DavidMolTor/TENG/Readme.md

# TENG

Research project on TENG energy harvesting.

## Introduction

TODO

## Features

TODO
