DavidMolTor/TENG/hardware/output/Rotor_Bottom.png

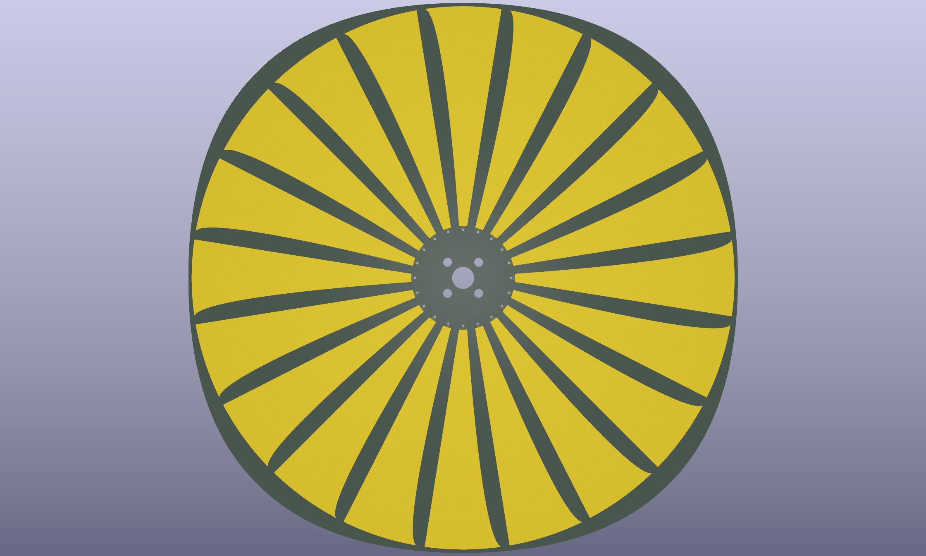
hardware/output/Rotor_Bottom.png
