DavidMolTor/TENG/hardware/output/Rotor_Front.png

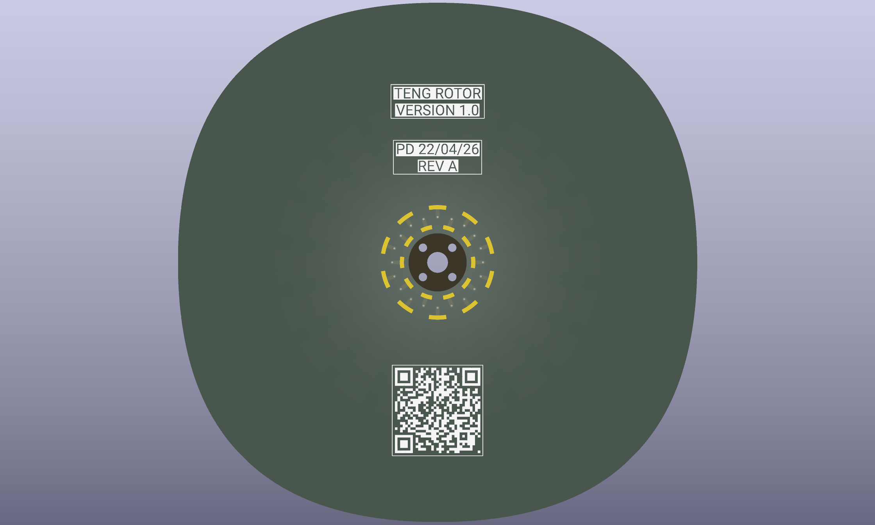
hardware/output/Rotor_Front.png
