DavidMolTor/TENG/hardware/output/Stator_Bottom.png

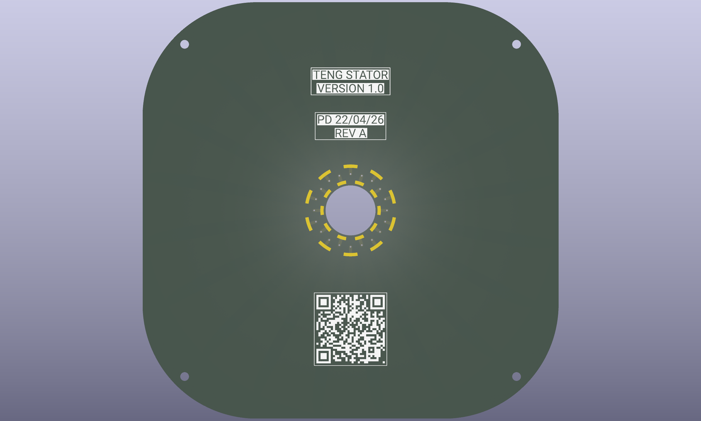
hardware/output/Stator_Bottom.png
