DavidMolTor/TENG/hardware/output/Stator_Front.png

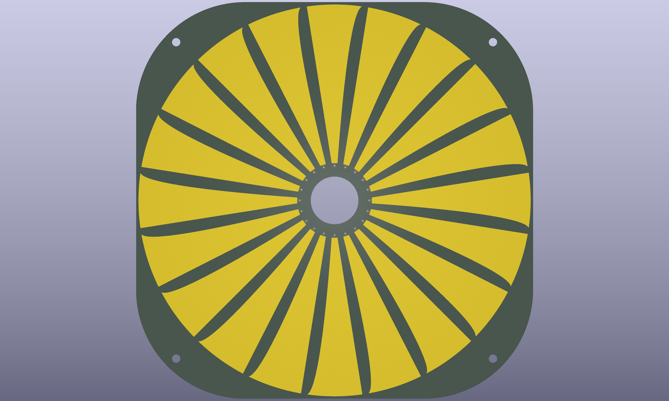
hardware/output/Stator_Front.png
