DavidMolTor/TENG/hardware/output/RotorV2.step

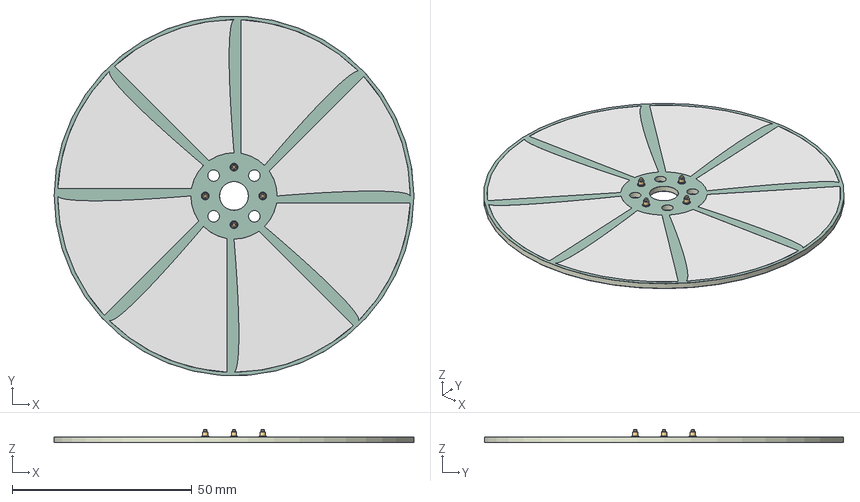
[picture p14: CAD file, 2026-10-27]
hardware/output/RotorV2.step
100.0 x 99.8 x 3.65 mm
Pogo x 4
Rotor_copper
Rotor_pad
Rotor_soldermask x 2
Rotor_PCB
