DavidMolTor/TENG/hardware/output/StatorV2.step

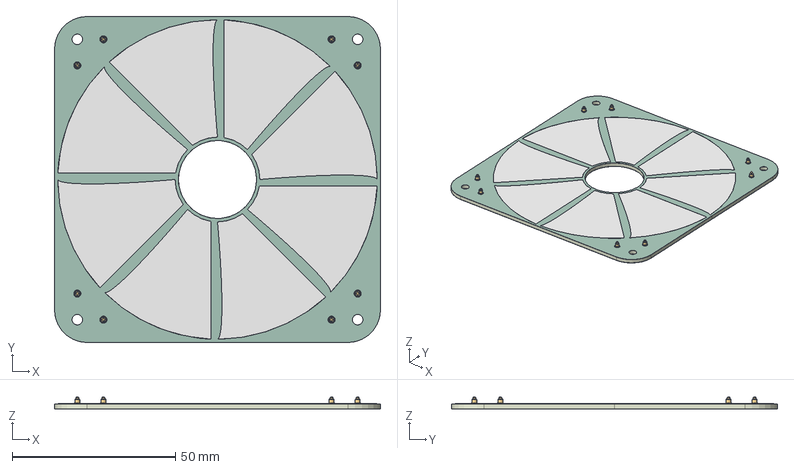
[picture p15: CAD file, 2026-10-27]
hardware/output/StatorV2.step
100.0 x 100.0 x 3.65 mm
Pogo x 8
Stator_copper
Stator_pad
Stator_soldermask x 2
Stator_PCB
