DavidMolTor/TENG/hardware/output/Base.step

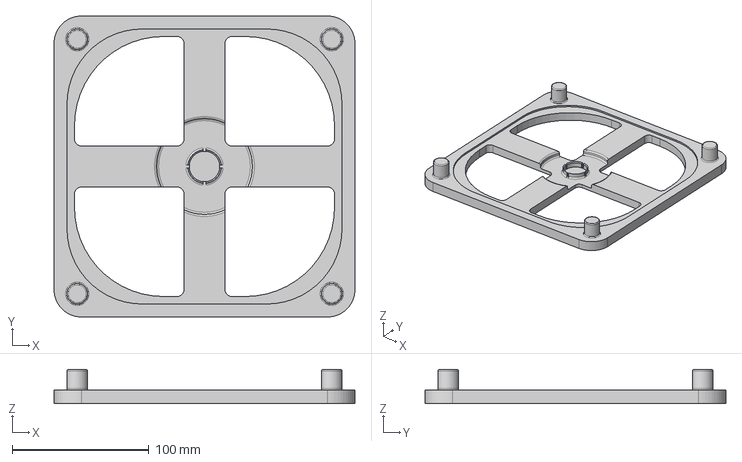
[picture p16: CAD file, 2026-06-24]
hardware/output/Base.step
220.0 x 220.0 x 25.0 mm
