DavidMolTor/TENG/hardware/output/Hub.step

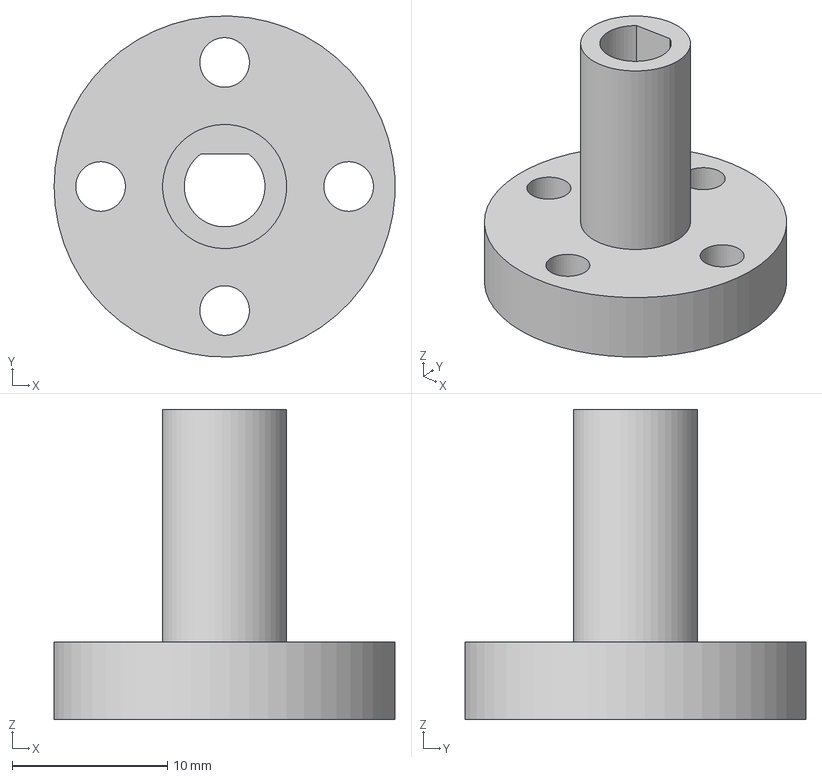
[picture p17: CAD file, 2026-06-24]
hardware/output/Hub.step
22.0 x 22.0 x 20.0 mm
