DavidMolTor/TENG/hardware/output/Top.step

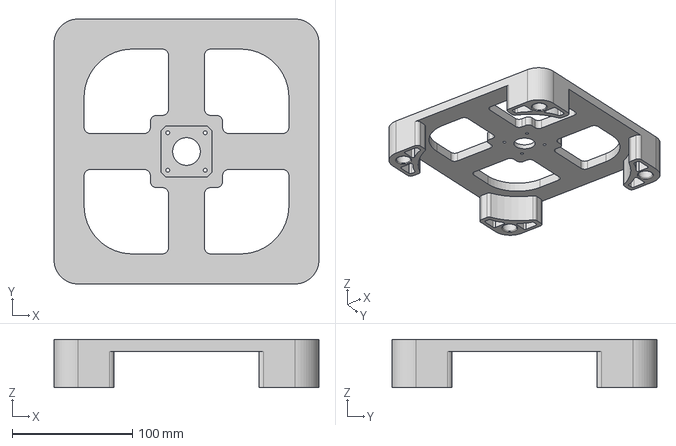
[picture p18: CAD file, 2026-04-27]
hardware/output/Top.step
220.0 x 220.0 x 40.0 mm
