DavidMolTor/TENG/hardware/output/Gasket.step

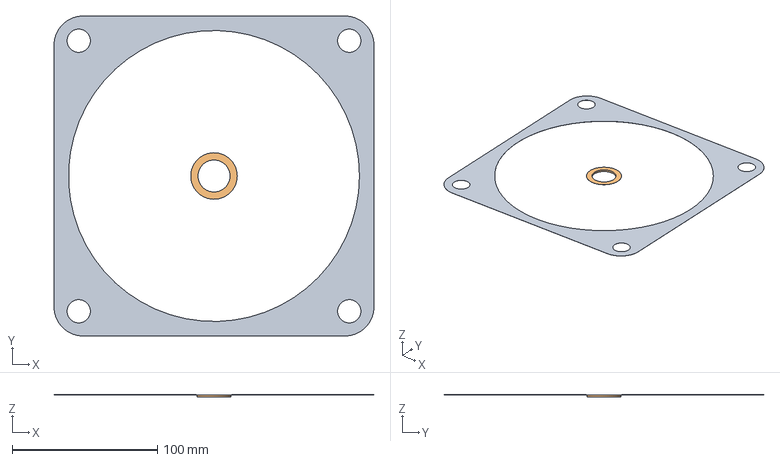
[picture p19: CAD file, 2026-04-27]
hardware/output/Gasket.step
220.0 x 220.0 x 1.70 mm
