DavidMolTor/TENG/hardware/output/Rotor.step

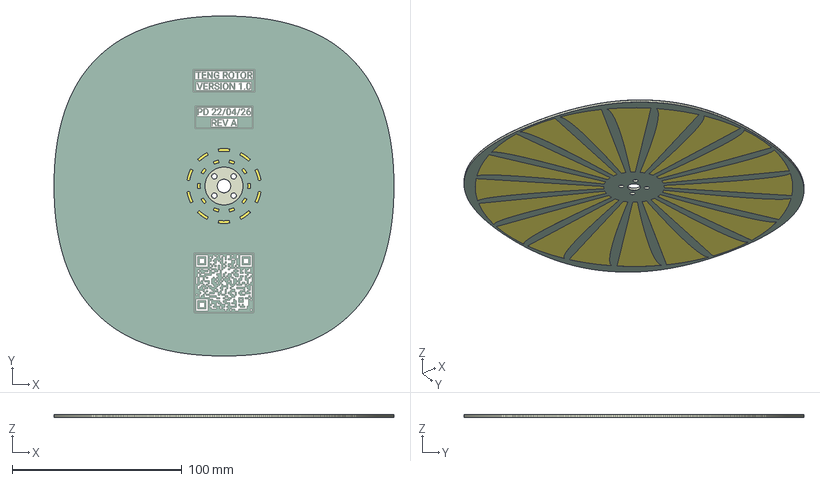
[picture p20: CAD file, 2026-06-24, an earlier design]
hardware/output/Rotor.step
200.0 x 200.0 x 1.64 mm
Rotor_copper
Rotor_via
Rotor_silkscreen
Rotor_soldermask
Rotor_soldermask_1
Rotor_PCB
