DavidMolTor/TENG/(list of files, cad)

Other CAD files:
hardware/output/Stator.step
