DavidMolTor/TENG/simulation/FSS_TENG_SW.asc

B1: bv; V = sigma * d * (1 - V(xt)) / eps0
B2: bv; V=0.5 * (1 + sin(w*time))
C1: cap; Q = Cmin + (Cmax - Cmin)*V(xt)
C2: cap; {Cload}
D1: diode; 1N4148
D2: diode; 1N4148
D3: diode; 1N4148
D4: diode; 1N4148
D5: diode; 1N4148
L1: ind2; 1m; Rser=1m
L2: ind2; 1m; Rser=1m
R1: res; {Rload}
R2: res; 10
S1: sw; SWTENG
Named nets: 0, xt, Vout, Vteng
.tran 0 20 0
* Constant values and derivatives *
.param sigma=100e-6 ; Triboelectric charge density
.param eps0=8.854e-12 ; Absolute permittivity
.param A=pi*R*R/N ; Area per segment
.param Cmax=eps0*A*Ve/d ; Overlap capacitance
.param Cmin=0.05*Cmax ; Minimum capacitance
.param w=N*2*pi*rpm/60 ; Angular velocity
* Configurable parameters *
.param N=10 ; Number of copper contacts
.param rpm=100 ; Rotational speed [rpm]
.param R=0.1 ; TENG radius [m]
.param d=1e-4 ; Air gap [m]
.param Rload=10Meg ; Load resistance[ohm]
.param Cload=2µ ; Load capacitor[F]
.param Ve=100 ; Excitation factor
.step param ix 1 5 1
K1 Lp Ls 1
.model SWTENG SW(Ron=1p Roff=1000Meg Vt=1000 Vh=900)
