DavidMolTor/TENG/simulation/TENG_GDT.asc

B2: bv; V=26.5e-006*V(xt)/8.85e-12
C1: cap; Q=(0.011*8.85e-12/(8.5e-5+V(xt)))*x
C2: cap; 10µ
C3: cap; 10n
D1: diode; 1N4148
D2: diode; 1N4148
D3: diode; 1N4148
D4: diode; 1N4148
R1: res; 1Meg
U1: GDT; 2087; dcVmax=100 Vmax1=200 Vmax2=190 Vglow=45 Varc=15
V1: voltage; SINE(0.42e-3 0.42e-3 3 0 0 -90)
Named nets: 0, xt
.tran 0 20 0 10u
