DavidMolTor/TENG/simulation/TENG_GDT_FULL.asc

B2: bv; V=26.5e-006*V(xt)/8.85e-12
C1: cap; Q=(0.011*8.85e-12/(8.5e-5+V(xt)))*x
C2: cap; 10µ
C3: cap; 4.7n
D1: diode; 1N4148
D2: diode; 1N4148
D3: diode; 1N4148
D4: diode; 1N4148
D5: diode; 1N4148
Lp: ind2; 5m; Rser=1m
Ls: ind2; 5m; Rser=1m
R1: res; 1Meg
U1: GDT; 2087; dcVmax=800 Vmax1=1400 Vmax2=1300 Vglow=45 Varc=13
V1: voltage; SINE(0.42e-3 0.42e-3 3 0 0 -90)
Named nets: 0, xt
.tran 0 5 3
K1 Lp Ls 1
