DavidMolTor/TENG/simulation/TENG_SW.asc

B2: bv; V=26.5e-006*V(xt)/8.85e-12
C1: cap; Q=(0.011*8.85e-12/(8.5e-5+V(xt)))*x
C2: cap; 10µ
D1: diode; 1N4148
D2: diode; 1N4148
D3: diode; 1N4148
D4: diode; 1N4148
D5: diode; 1N4148
Lp: ind2; 1m; Rser=1m
Ls: ind2; 1m; Rser=1m
R1: res; 1Meg
R2: res; 10
S1: sw; SWTENG
V1: voltage; SINE(0.42e-3 0.42e-3 3 0 0 -90)
Named nets: 0, xt, Vteng, Vout, Vsw
.tran 0 10 0
.model SWTENG SW(Ron=1p Roff=1000K Vt=1000 Vh=900)
K1 Lp Ls 1
