DavidMolTor/TENG/hardware/stator/Stator.kicad_pcb

## KiCad design hardware/stator/Stator.kicad_pcb (2026-10-27)

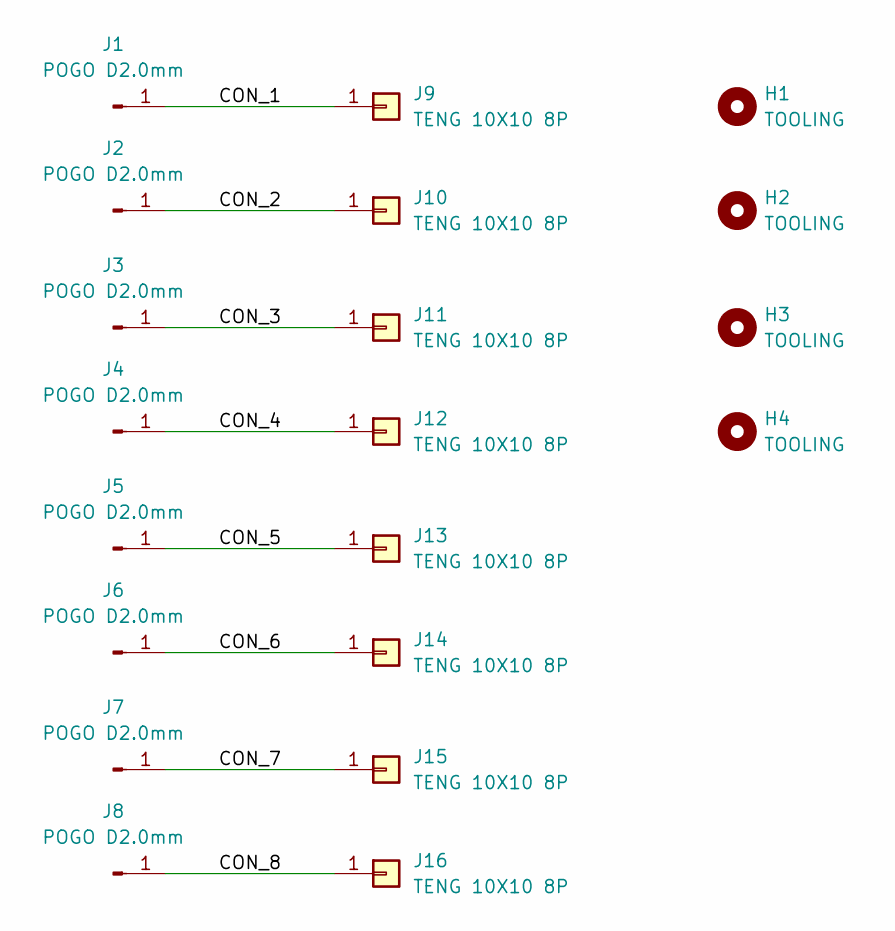
[picture p21: schematic Stator.kicad_sch, FSS TENG STATOR]

Parts:
H1, H2, H3, H4: TOOLING; ToolingHole_1.152mm
J1, J2, J3, J4, J5, J6, J7, J8: POGO D2.0mm; PogoPin_D2.0mm_JOIN; Manufacturer Part YZ203115028R-03; JLC Part C5157421
J9, J10, J11, J12, J13, J14, J15, J16: TENG 10X10 8P; CONTACT_CIRCLE_10X10_8P_HUB

Connections:
/CON_1: J1.1 (Pin_1_1), J9.1 (Pin_1_1)
/CON_2: J2.1 (Pin_1_1), J10.1 (Pin_1_1)
/CON_3: J3.1 (Pin_1_1), J11.1 (Pin_1_1)
/CON_4: J4.1 (Pin_1_1), J12.1 (Pin_1_1)
/CON_5: J5.1 (Pin_1_1), J13.1 (Pin_1_1)
/CON_6: J6.1 (Pin_1_1), J14.1 (Pin_1_1)
/CON_7: J7.1 (Pin_1_1), J15.1 (Pin_1_1)
/CON_8: J8.1 (Pin_1_1), J16.1 (Pin_1_1)

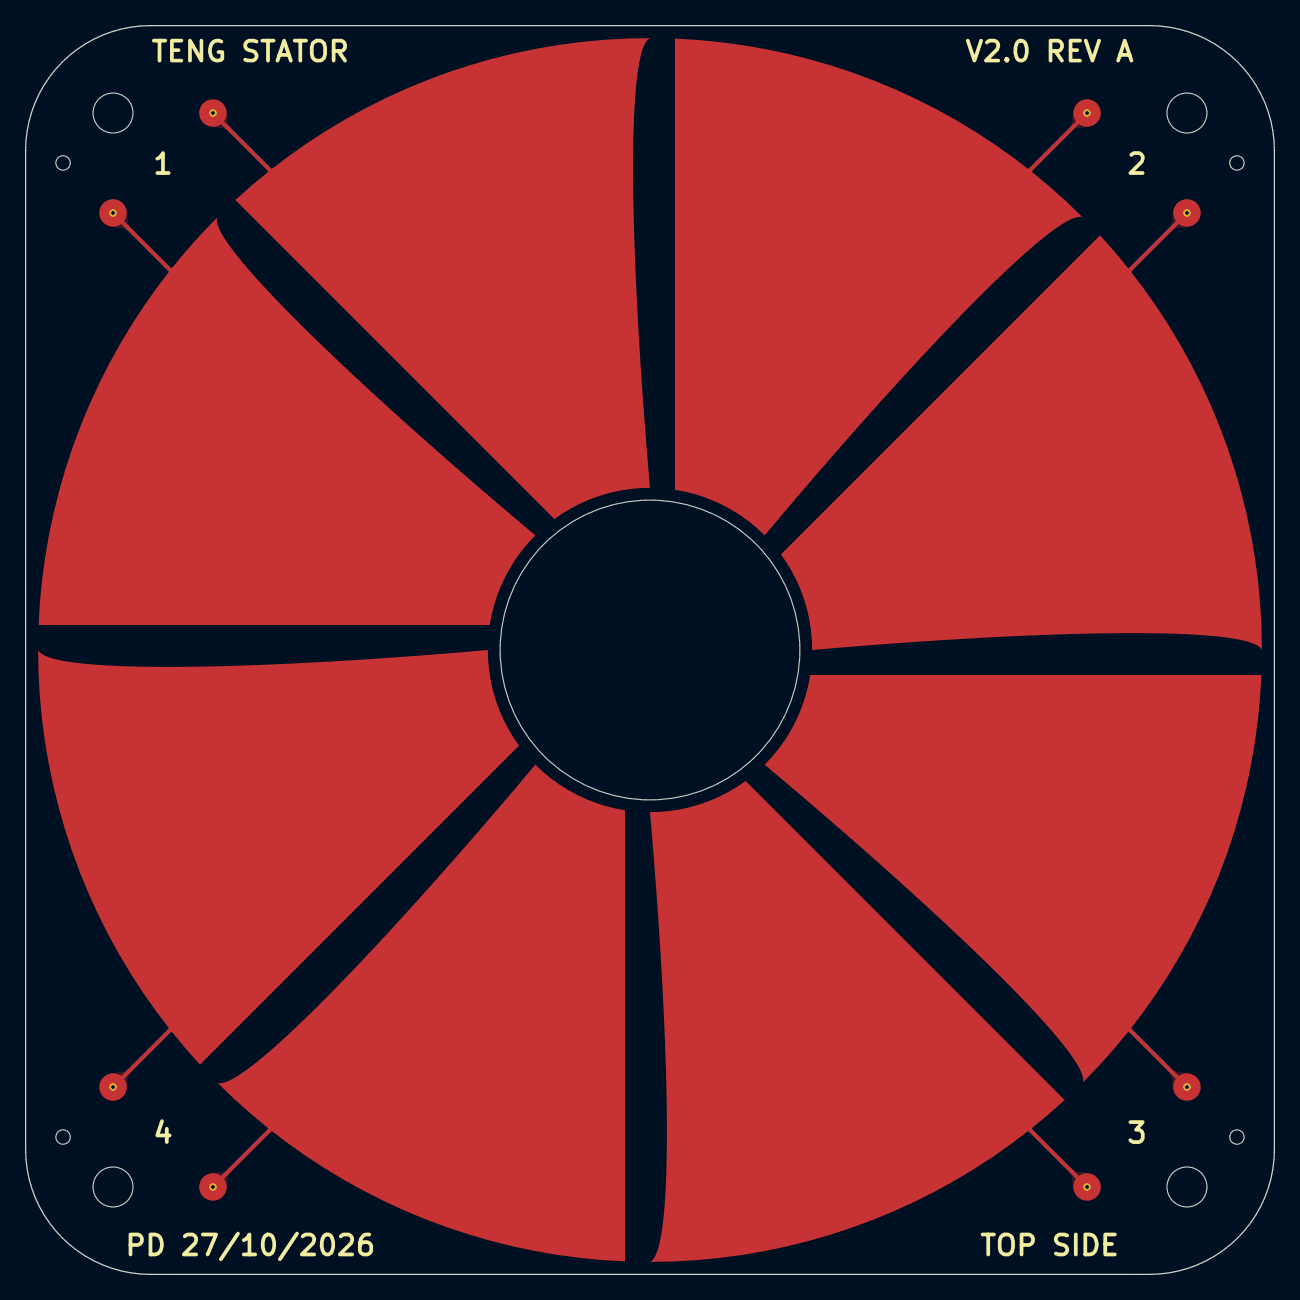
[picture p22: board Stator.kicad_pcb from above]

Board: 2 copper layers, 100.0 x 100.0 mm, 20 parts (0 on the bottom side), 8 nets.
