DavidMolTor/TENG/hardware/rotor/Rotor.kicad_pcb

## KiCad design hardware/rotor/Rotor.kicad_pcb (2026-10-27)

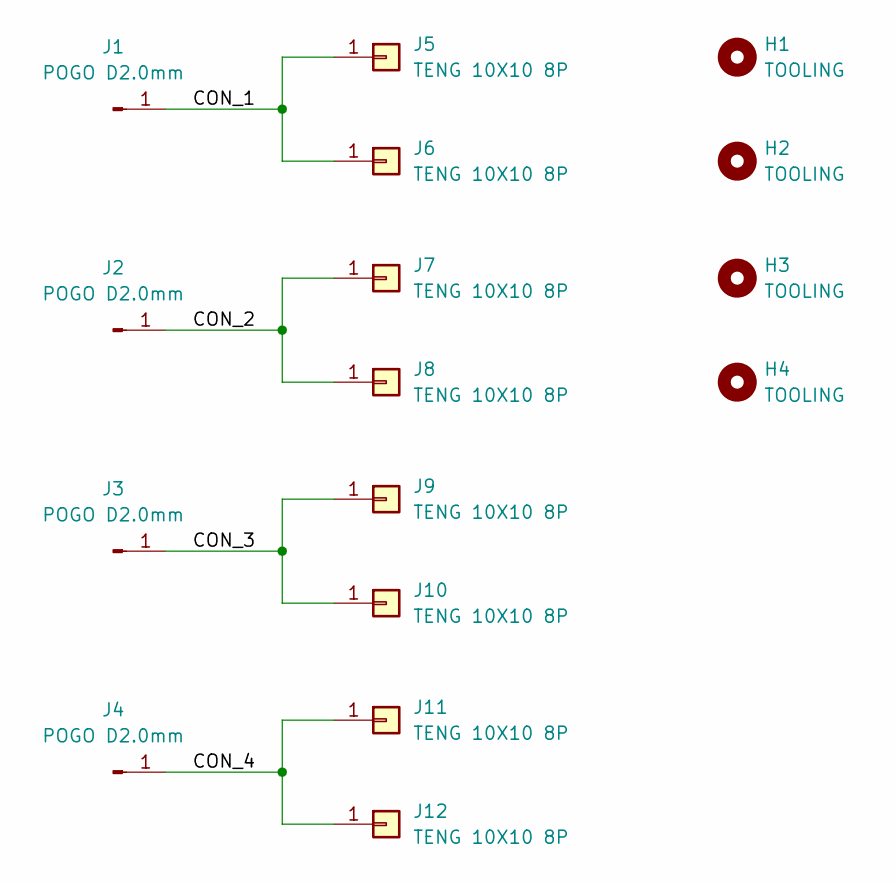
[picture p23: schematic Rotor.kicad_sch, FSS TENG ROTOR]

Parts:
H1, H2, H3, H4: TOOLING; ToolingHole_1.152mm
J1, J2, J3, J4: POGO D2.0mm; PogoPin_D2.0mm_JOIN; Manufacturer Part YZ203115028R-03; JLC Part C5157421
J5, J6, J7, J8, J9, J10, J11, J12: TENG 10X10 8P; CONTACT_CIRCLE_10X10_8P

Connections:
/CON_1: J1.1 (Pin_1_1), J5.1 (Pin_1_1), J6.1 (Pin_1_1)
/CON_2: J2.1 (Pin_1_1), J7.1 (Pin_1_1), J8.1 (Pin_1_1)
/CON_3: J3.1 (Pin_1_1), J9.1 (Pin_1_1), J10.1 (Pin_1_1)
/CON_4: J4.1 (Pin_1_1), J11.1 (Pin_1_1), J12.1 (Pin_1_1)

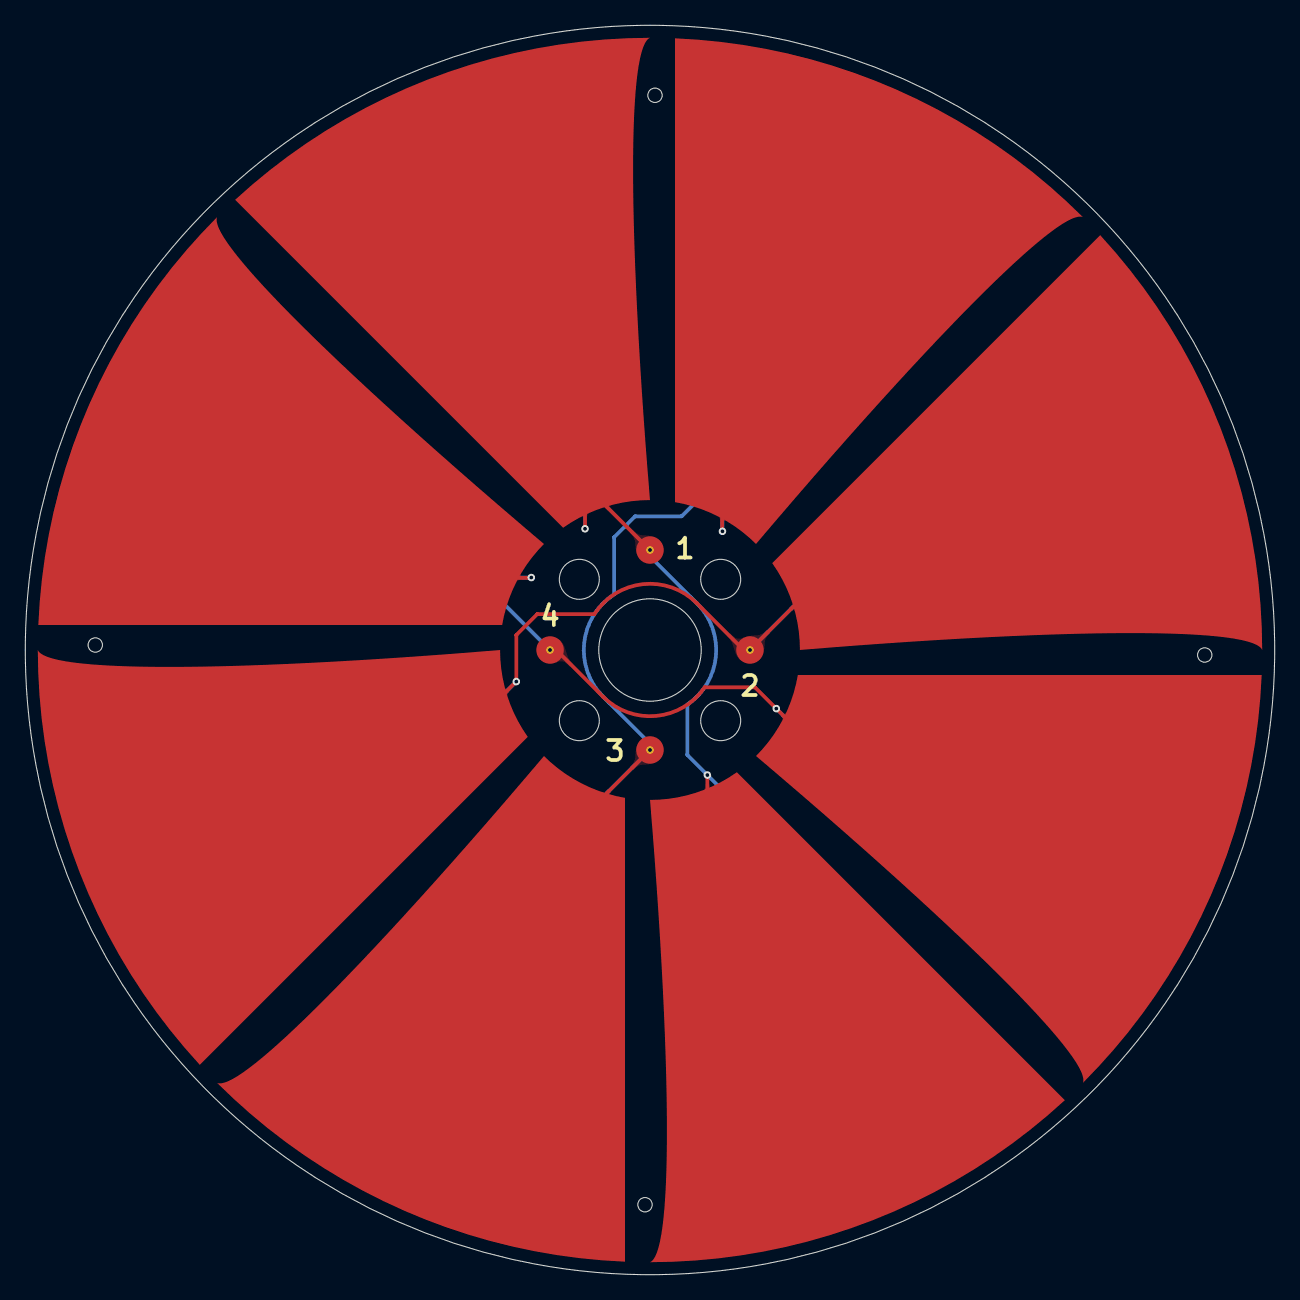
[picture p24: board Rotor.kicad_pcb from above]

Board: 2 copper layers, 100.0 x 100.0 mm, 16 parts (0 on the bottom side), 4 nets.
