DavidMolTor/TENG/hardware/power/Power.kicad_pcb

## KiCad design hardware/power/Power.kicad_pcb (2026-06-24)

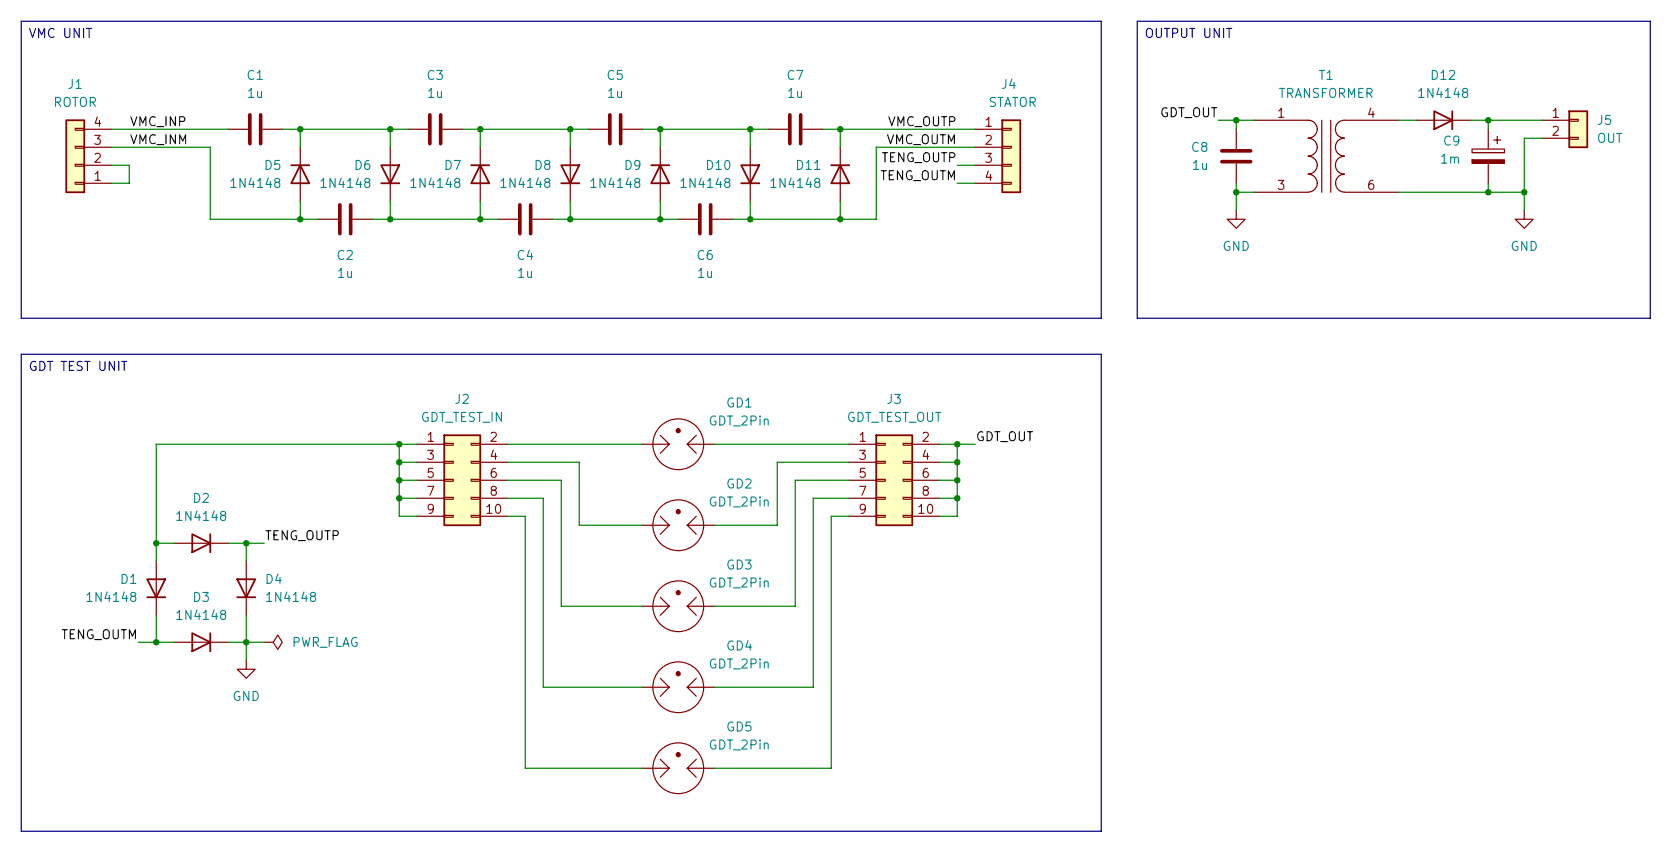
[picture p25: schematic Power.kicad_sch]

Parts:
C1, C2, C3, C4, C5, C6, C7, C8: 1u; C_Rect_L10.0mm_W4.0mm_P7.50mm_FKS3_FKP3
C9: 1m; CP_Radial_D17.0mm_P7.50mm
D1, D2, D3, D4, D5, D6, D7, D8, D9, D10, D11, D12: 1N4148; D_DO-35_SOD27_P7.62mm_Horizontal
GD1, GD2, GD3, GD4, GD5: GDT_2Pin; GDT_Bourns_2038
J1: ROTOR; TerminalBlock_Phoenix_MKDS-1,5-4_1x04_P5.00mm_Horizontal
J2: GDT_TEST_IN; PinHeader_2x05_P2.54mm_Vertical
J3: GDT_TEST_OUT; PinHeader_2x05_P2.54mm_Vertical
J4: STATOR; TerminalBlock_Phoenix_MKDS-1,5-4_1x04_P5.00mm_Horizontal
J5: OUT; TerminalBlock_Phoenix_MKDS-1,5-2_1x02_P5.00mm_Horizontal
T1: TRANSFORMER; Transformer_NF_ETAL_P1165

Connections:
/GDT_OUT: C8.1, J3.2, J3.4, J3.6, J3.8, J3.10, T1.1 (AA)
/TENG_OUTM: D1.1 (K), D3.2 (A), J4.4
/TENG_OUTP: D2.1 (K), D4.2 (A), J4.3
/VMC_INM: C2.2, D5.2 (A), J1.3
/VMC_INP: C1.1, J1.4
/VMC_OUTM: C6.1, D10.1 (K), D11.2 (A), J4.2
/VMC_OUTP: C7.2, D11.1 (K), J4.1
GND: C8.2, C9.2, D3.1 (K), D4.1 (K), J5.2, T1.3 (AB), T1.6 (SA)
unnamed: D1.2 (A), D2.2 (A), J2.1, J2.3, J2.5, J2.7, J2.9
unnamed: C1.2, C3.1, D5.1 (K), D6.2 (A)
unnamed: C2.1, C4.2, D6.1 (K), D7.2 (A)
unnamed: C3.2, C5.1, D7.1 (K), D8.2 (A)
unnamed: C4.1, C6.2, D8.1 (K), D9.2 (A)
unnamed: C5.2, C7.1, D9.1 (K), D10.2 (A)
unnamed: D12.2 (A), T1.4 (SB)
unnamed: C9.1, D12.1 (K), J5.1
unnamed: J1.1, J1.2
unnamed: GD1.3, J2.2
unnamed: GD2.3, J2.4
unnamed: GD3.3, J2.6
unnamed: GD4.3, J2.8
unnamed: GD5.3, J2.10
unnamed: GD1.1, J3.1
unnamed: GD2.1, J3.3
unnamed: GD3.1, J3.5
unnamed: GD4.1, J3.7
unnamed: GD5.1, J3.9

Notes on the sheet:
OUTPUT UNIT
GDT TEST UNIT
VMC UNIT

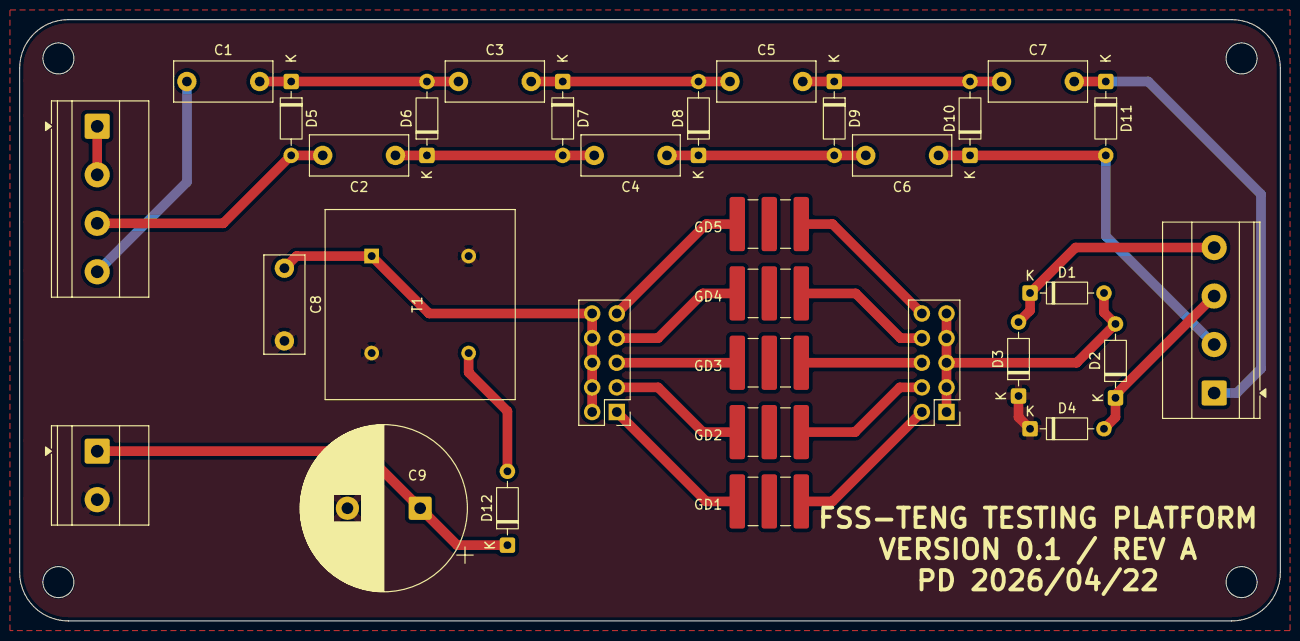
[picture p26: board Power.kicad_pcb from above]

Board: 2 copper layers, 130.0 x 62.0 mm, 32 parts (0 on the bottom side), 27 nets.
