DavidMolTor/TENG/(commit log)

2026-01-09 Update files
    Updated the ignore file for KiCAD projects.
    Added a license file.
    Added a readme file.
2026-01-10 Generator design files
    Added the rotor PCB design files.
    Added the stator PCB design files.
    [Rotor.kicad_pcb, Rotor.kicad_sch, Stator.kicad_pcb, Stator.kicad_sch]
2026-01-11 Generator design
    Updated the rotor design.
    Updated the stator design.
    [Rotor.kicad_pcb, Stator.kicad_pcb]
2026-01-11 Generator models
    Added a rotor 3D model.
    Added a stator 3D model.
    [Rotor.step, Stator.step]
2026-01-11 Rotor and generator models
    Updated the rotor 3D model.
    Updated the stator 3D model.
    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
    [Rotor.kicad_pcb, Rotor.step, Stator.step]
2026-01-11 Libraries and generator design
    Updated the generator design.
    Added a libraries folder.
    [Rotor.kicad_pcb, Stator.kicad_pcb]
2026-01-12 Generator design
    Updated the rotor board design.
    Updated the stator board design.
    [Rotor.kicad_pcb, Rotor.step, Stator.kicad_pcb, Stator.step]
2026-01-12 Generator pictures
    Added pictures of the TENG generator boards.
2026-01-25 Simulation and PCB design
    Added an initial FSS TENG simulation profile.
    Added a NEMA17 motor 3D model.
    Updated the stator PCB design.
    [Stator.kicad_pcb]
2026-04-22 Project update
    Updated the project to work with KiCad 10.0.
    Updated the exposed pad areas for both layouts.
    [Rotor.kicad_pcb, Rotor.kicad_sch, Stator.kicad_pcb, Stator.kicad_sch]
2026-04-22 Fabrication models
    Added missing models.
    Updated both PCB models.
    [Base.step, Gasket.step, Rotor.step, Stator.step, Top.step]
2026-04-27 TENG layout
    Updated the TENG layout.
    Increased the hub gap area for both layouts.
    [Rotor.kicad_pcb, Rotor.kicad_sch, Rotor.step, Stator.kicad_pcb, Stator.kicad_sch]
2026-04-27 Fabrication models
    Updated the fabrication model for the stator.
    Updated the fabrication model for the rotor.
    [Rotor.kicad_pcb, Rotor.step, Stator.kicad_pcb, Stator.step]
2026-04-27 Testbench models
    Updated the fabrication models for the testbench.
    [Base.step, Gasket.step, Top.step]
2026-06-24 Board layout models
    Updated the rotor PCB layout.
    Updated the stator PCB layout.
    Updated the component models.
    [Base.step, Hub.step, Rotor.kicad_pcb, Rotor.step, Stator.kicad_pcb, Stator.step]
2026-06-24 Initial spring article
    Added the initial template for the spring article.
2026-06-24 Power testing
    Added a power testing platform.
    [Power.kicad_pcb, Power.kicad_sch]
2026-06-25 First spring article draft
    Updated the main body of the article.
    Added images, tables and references.
2026-06-25 Second spring article draft
    Moved references, images and tables.
    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
2026-10-10 Libraries and article
    Added new 3D models.
    Updated the 2026 spring article.
    Updated the rotor board layout.
2026-10-24 Contacts library
    Created a library for the TENG contacts.
    Added some footprints for the 10x10cm TENG.
2026-10-24 Pogo pin and schematic
    Added the pogo pin footprint and model.
    Updated the rotor schematic.
2026-10-24 Generator layouts and footprints
    Updated the TENG footprint library.
    Updated the rotor and stator PCB layouts.
    Generated new 3D models for the rotor and stator.
2026-10-27 Pogo pin and production
    Changed the pogo pins for ones with greater overall length, this takes into accout the thickness of the dielectric film.
    Added the version information to the boards.
    Built the production files.
